fsantagostinobietti/mymaglev/(threads)

Thread 1 (2024-05-26):

Position of the Hall sensor

DB9JG, 2024-05-26:
I like this project and your good solution with the unmodified electromagnet and can actually confirm all your experiences. I see my setup mentioned in your link list. I was able to successfully position the Hall sensor under the electromagnet with a modification. For this to work well, however, I had to avoid the U or cup shape of the core (made this way to hold an iron plate) and turn it into a bar magnet where the magnetic poles are far apart.  This avoids a magnetic short circuit and a (too) strong magnetic field between the poles with the sensor in between. On the one hand, such an  open construction will weaken the controllable magnetic field. However, if the mechanical load is a permanent magnet, then the main force for pulling up the load comes from the permanent magnet itself. And in this case, a very small additional controlled magnetic field strength can keep the magnet just at the levitation point. In addition, the sensor "sees" much more of the permanent magnetic field (indicating the distance) and less of a switched field. A small hysteresis at the switching threshold also helped to stabilize - But PID is certainly the more optimal way.

Thanks for this version and your thoughts!
Peter
