fsantagostinobietti/mymaglev/(commit log)

2021-09-27 circuit diagram
2021-09-27 hall sensor position diagram
2021-09-28 added BOM
2021-09-29 better pid params value
2021-09-29 pid computation as float instead of int
2021-10-25 replaced BJT transistor with MOSFET one
    Diagram edited with free online editor: www.circuit-diagram.org/editor/
2021-10-25 from BJT to MOSFET transistor
    BJT became too hot and burned after 1 hour. MOSFET is much better.
2021-10-26 pull-down resistor
